smfindley/rad-passenger-seat/out/preview_bottom.png

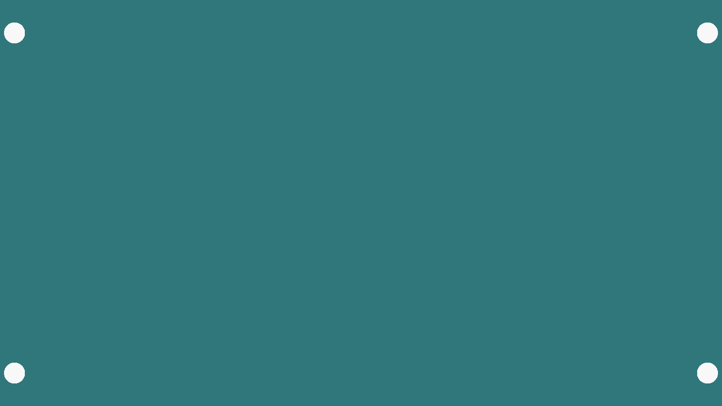
out/preview_bottom.png
