smfindley/rad-passenger-seat/out/preview_split_seam.png

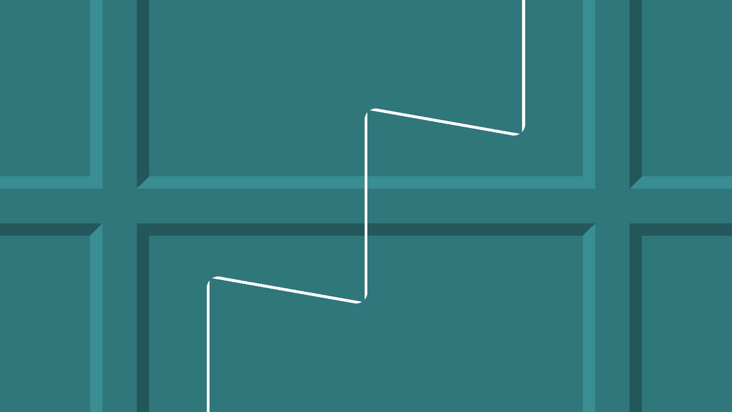
out/preview_split_seam.png
