smfindley/rad-passenger-seat/out/seat_board_half.3mf

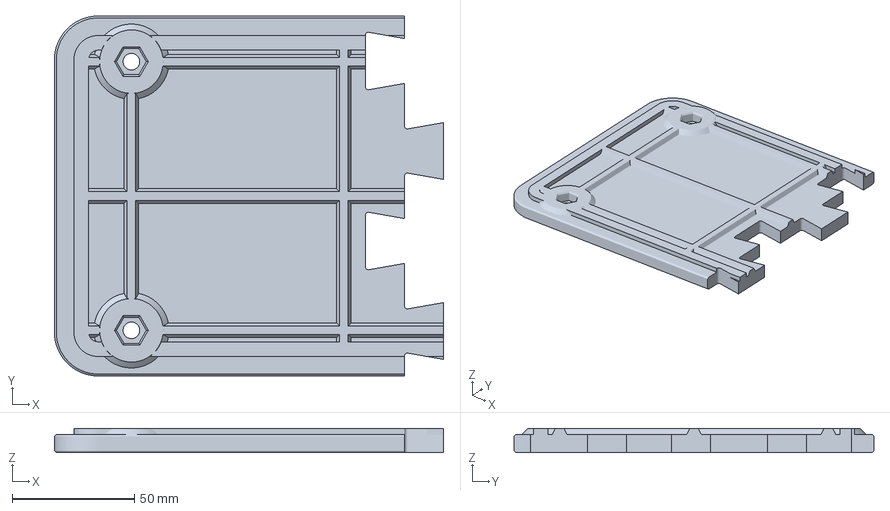
[picture p10: CAD file, 2026-11-04]
out/seat_board_half.3mf
159.4 x 147.4 x 10.0 mm
