smfindley/rad-passenger-seat/out/seat_board.stl

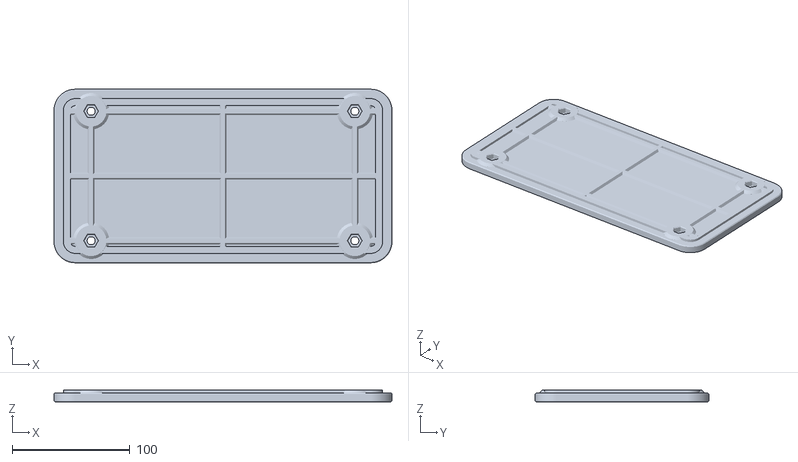
[picture p11: CAD file, 2026-11-04]
out/seat_board.stl
287.1 x 147.4 x 10.0
