smfindley/rad-passenger-seat/out/bolt_pad_modifier.stl

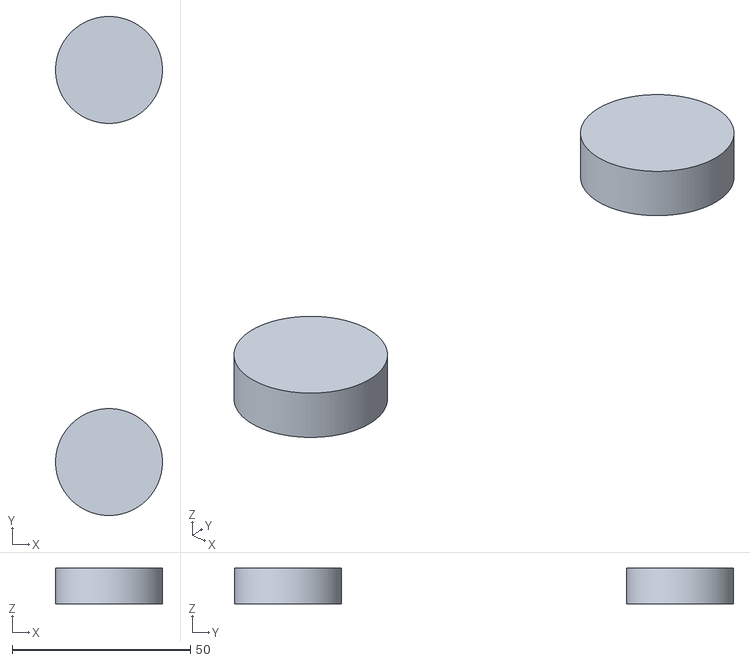
[picture p12: CAD file, 2026-11-04]
out/bolt_pad_modifier.stl
30.0 x 140.0 x 10.0
