smfindley/rad-passenger-seat/seat_board.scad

// One-piece board (needs a bed at least 292 x 152 mm).
include <seat_board_lib.scad>

seat_board();
