smfindley/rad-passenger-seat/(list of files, cad)

Other CAD files:
out/seat_board_half.stl
