smfindley/rad-passenger-seat/(commit log)

2026-11-03 RAD passenger seat base board: M6 bolt-on plate with dovetail split
    OpenSCAD parametric plate (10 mm envelope, 7.5 mm plate) that fits inside
    a passenger seat cushion cover and bolts to the frame through four hex
    traps. Includes one-piece and two-piece dovetail versions, a 3MF for Orca,
    a bolt-pad infill modifier, previews and mesh validation scripts.
    [bolt_pad_modifier.scad, bolt_pad_modifier.stl, check_pair.scad, preview_hole.scad, seat_board.scad, seat_board.stl, seat_board_half.3mf, seat_board_half.stl]
2026-11-03 Fit: 5 mm margin all round, bolt pads trimmed to 26 mm
    Shrink the board from 291.1 x 151.4 to 282.1 x 142.4 mm (side_clear 5.0)
    so it is not razor-tight in the cover. The 34 mm bolt pads would then
    overhang the long edges, so they are reduced to 26 mm - still well clear
    of the M6 hex traps - keeping the part exactly inside the new outline.
    Rebuild meshes, 3MF, modifier and previews; update README dimensions,
    volumes and filament estimates.
    [bolt_pad_modifier.scad, bolt_pad_modifier.stl, seat_board.stl, seat_board_half.3mf, seat_board_half.stl, seat_board_lib.scad]
2026-11-03 Fit: 5 mm total margin, 2.5 mm per side
    Board is 287.1 x 147.4 mm (was 282.1 x 142.4). The 26 mm bolt pads need
    no further change - they still leave a 3.3 mm ledge to the long edge.
    Rebuild meshes, 3MF and previews; update README dimensions, volumes and
    filament estimates.
    [bolt_pad_modifier.stl, seat_board.stl, seat_board_half.3mf, seat_board_half.stl, seat_board_lib.scad]
2026-11-04 Bolt pattern: increase eye-to-eye length to 224 mm
    Move the two end bolt stations to x = +/-112 (pitch_x 223 -> 224). Update
    the hole-section preview to cut through the new station and the README
    bolt-pattern row. Meshes, 3MF and previews rebuilt; volumes unchanged.
    [bolt_pad_modifier.stl, preview_hole.scad, seat_board.stl, seat_board_half.3mf, seat_board_half.stl, seat_board_lib.scad]
2026-11-04 Add dimensioned schematics and refresh README
    - make_schematic.py reads the SCAD parameters and emits a dimensioned
    plan view and bolt-station/height section as SVG
    - README gains a Schematic section and the bolt-station render
    - build.sh regenerates the schematics
    - fix 3MF zip timestamps so rebuilds are byte-identical
    [seat_board_half.3mf]
